AIYAA-1011/triple-J---UAV/飞控原理图&PCB.docx

## Part 1 简介

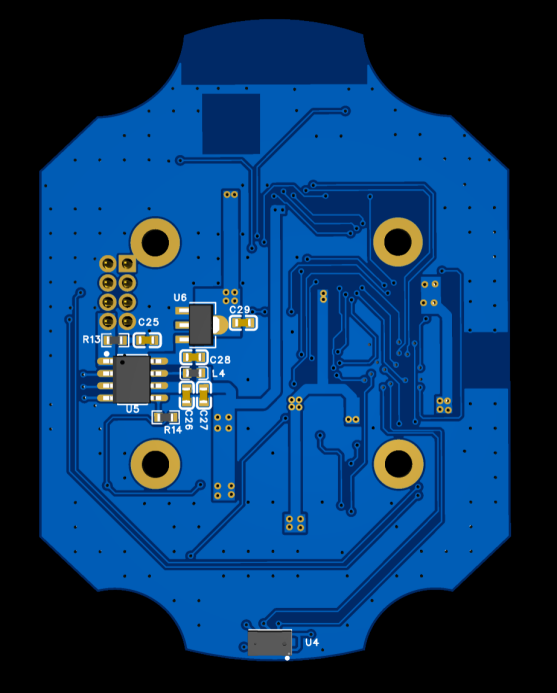
[picture p27: figure]
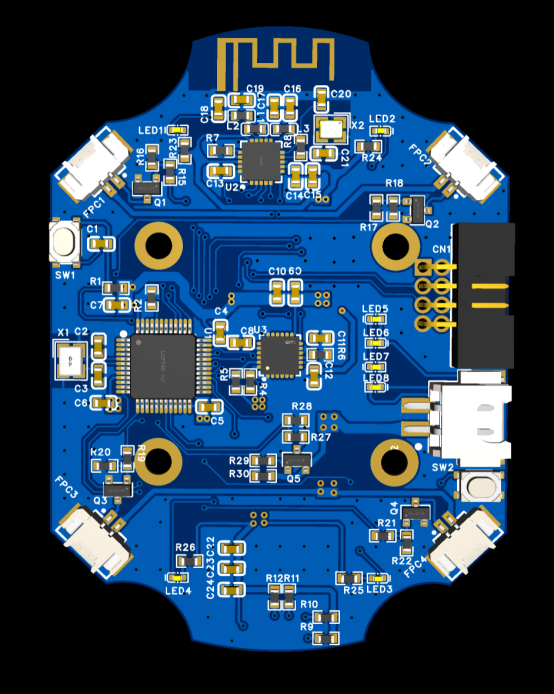
[picture p28: figure]

## Part 2 原理图具体细节

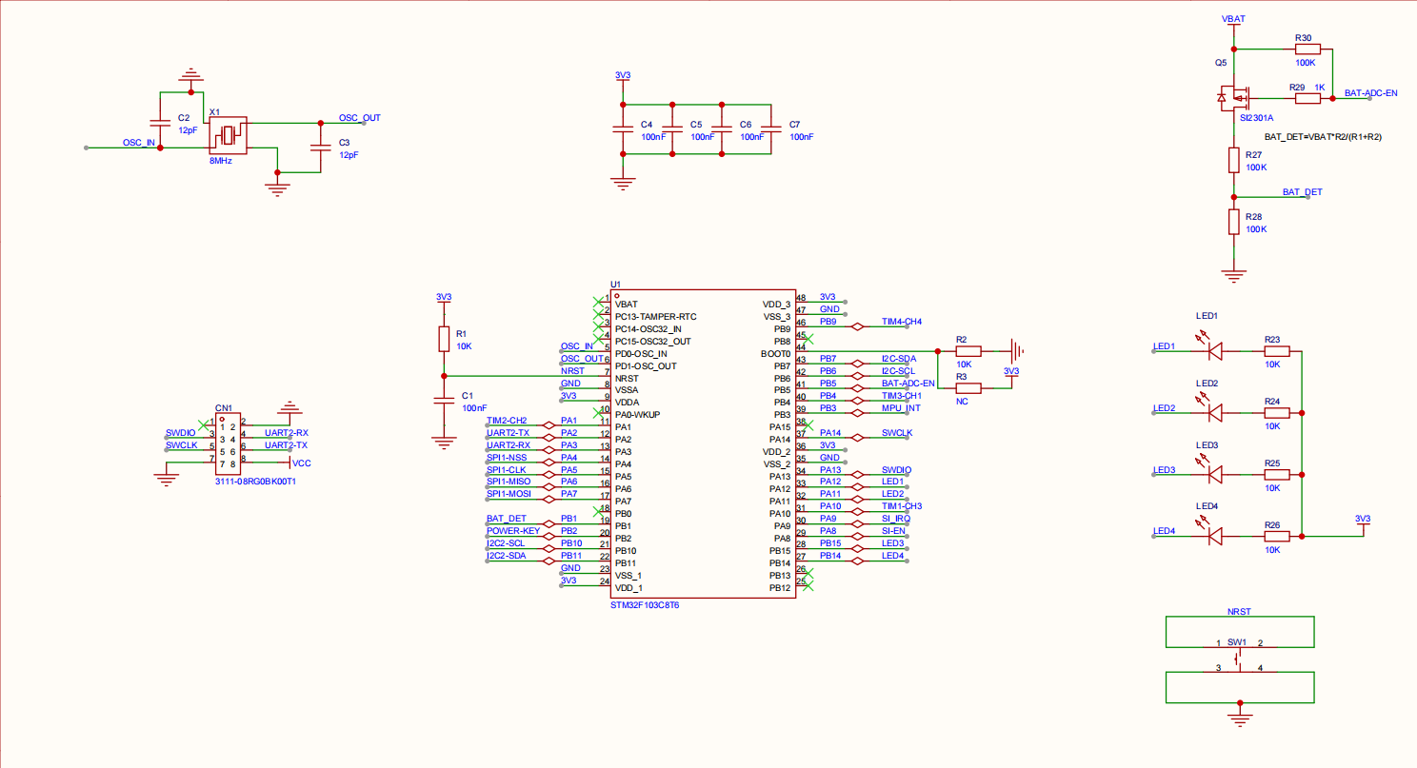
[picture p29: figure]
屏幕截图 2026-07-25 225838
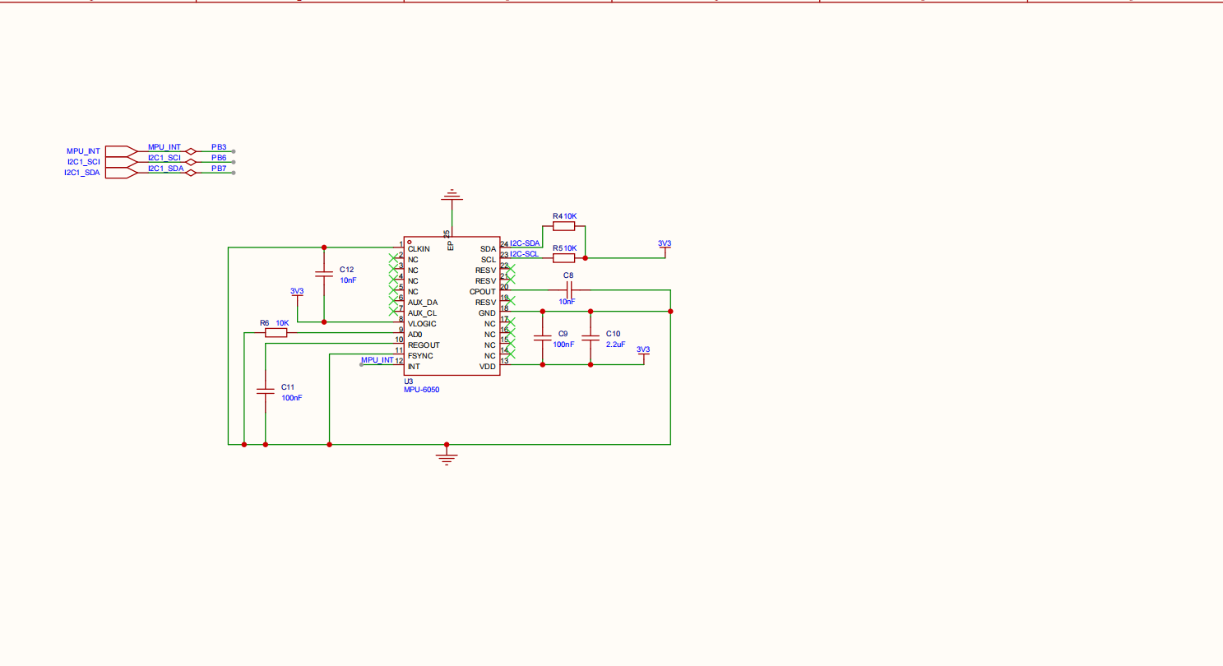
[picture p30: figure]
屏幕截图 2026-07-25 225851
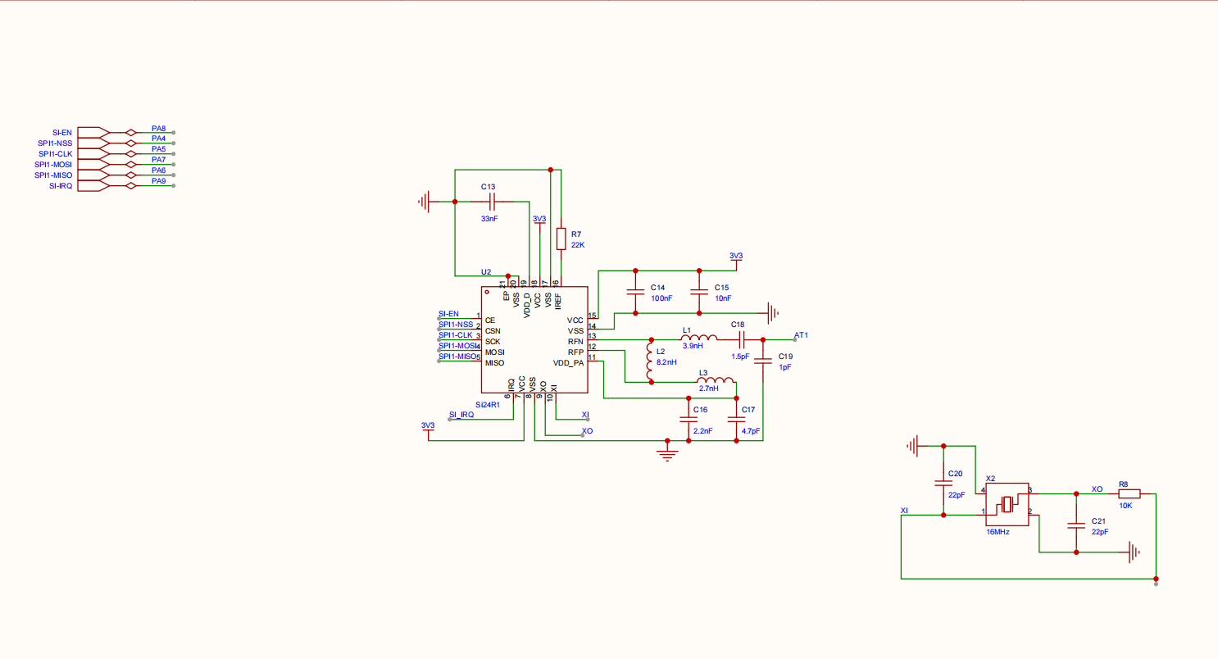
[picture p31: figure]
屏幕截图 2026-07-25 225900
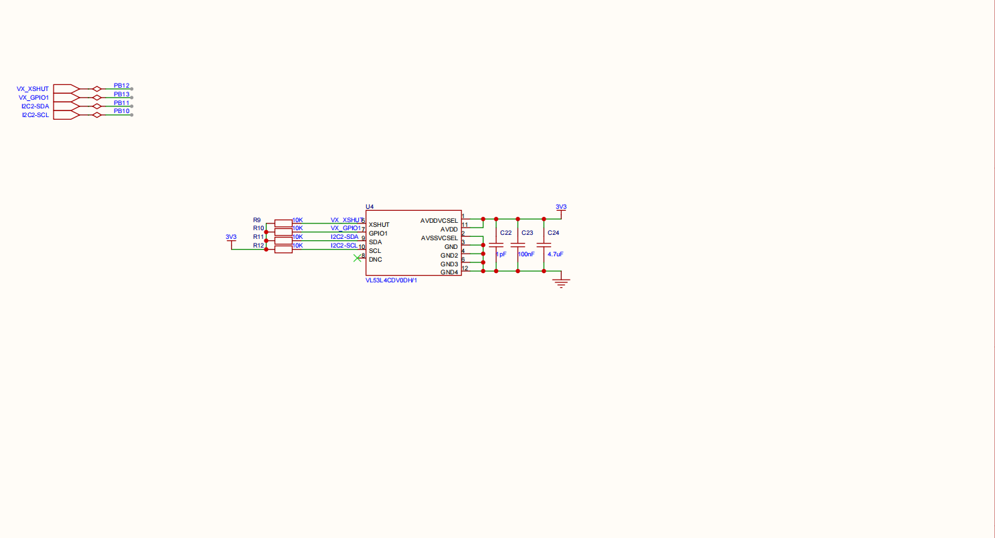
[picture p32: figure]
屏幕截图 2026-07-25 225908
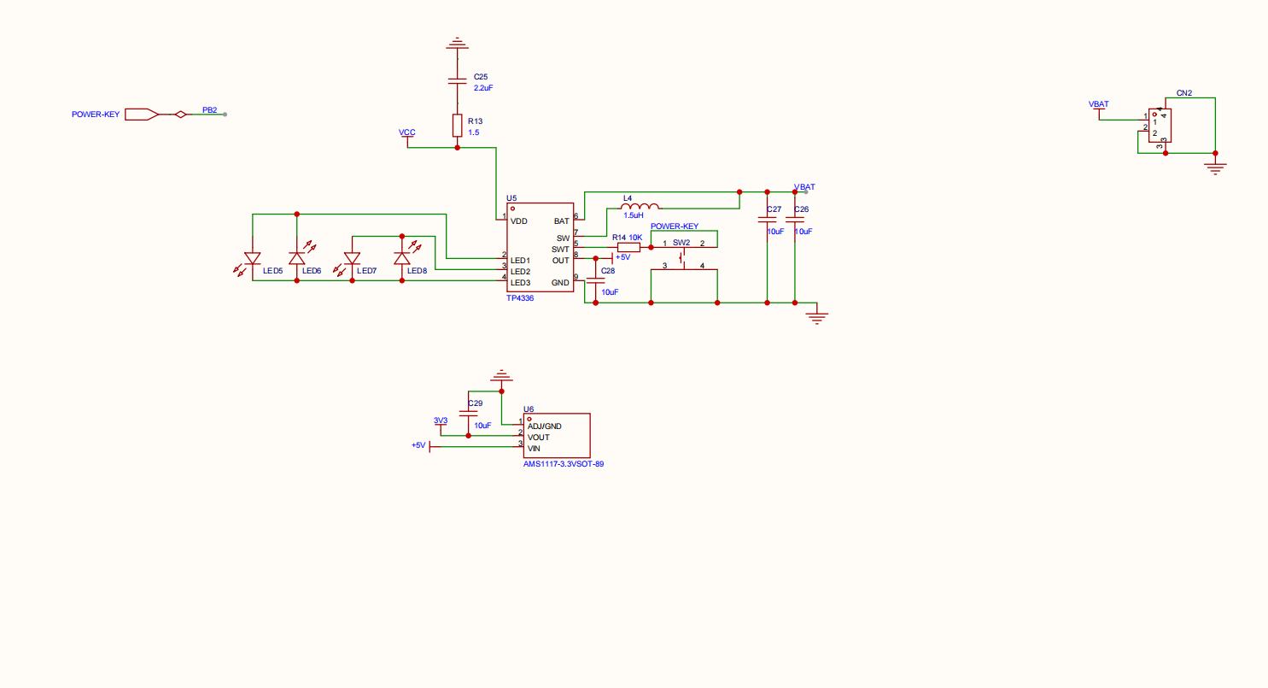
[picture p33: figure]
屏幕截图 2026-07-25 225916
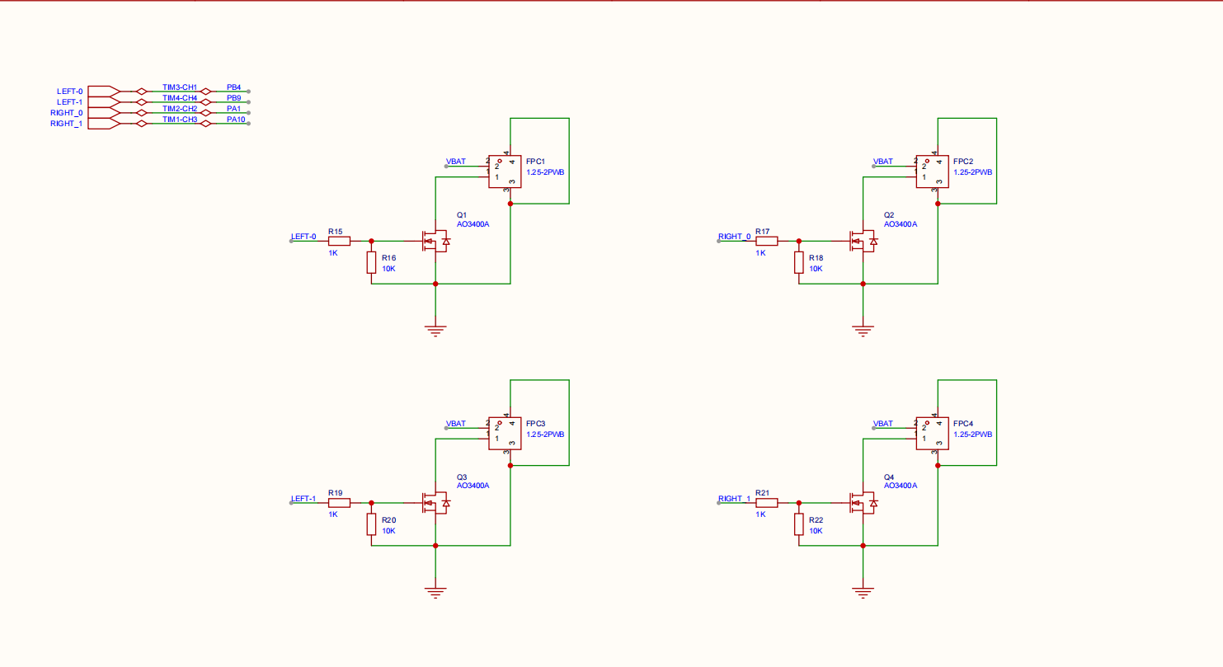
[picture p34: figure]
屏幕截图 2026-07-25 225924

## Part 3 PCB走线

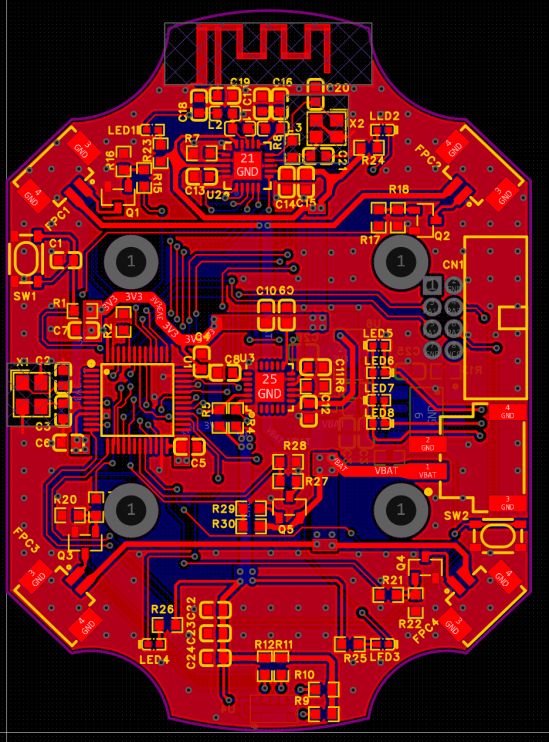
[picture p35: figure]
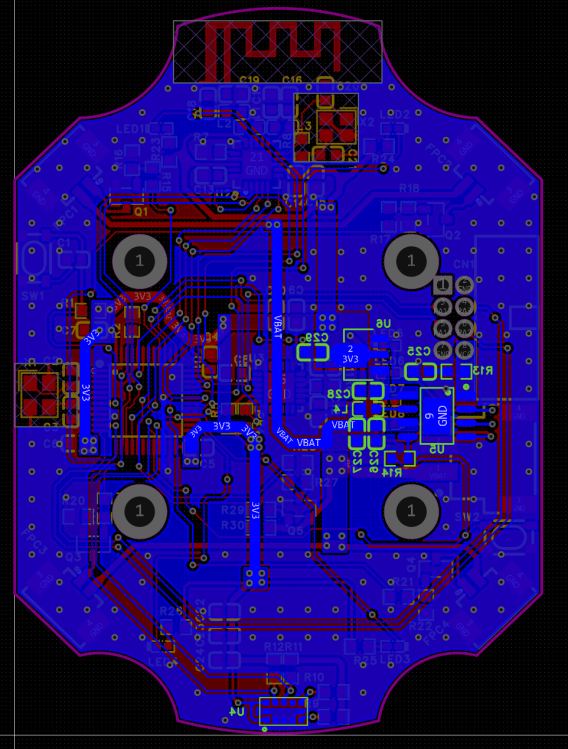
[picture p36: figure]

## Part 4 总结

1. PCB走线规划：网络布局，同一层的线路尽量保持同一走向，避免出现线路走不通或铺铜“孤岛”出现，尤其在元器件较多时，可以减少调整的时间。
2. 元器件布局：陀螺仪要放在机器的中心，确保读数准确；天线区域正反都不能铺铜，避免干扰；晶振尽量不要放在边缘，容易损坏。\

杨施杰

2026/8/28
