AIYAA-1011/triple-J---UAV/滤波和姿态解算.docx

滤波处理数据

问题：采集到的数据抖动（有毛刺）

对角速度进行低通滤波（对采集的数据时效性要求高、精度上较宽容，适合低通滤波）：

输出值=加权系数*上次输出值+（1-加权系数）*本次测量值

对加速度进行卡尔曼滤波（加速度抖动更剧烈，低通滤波不够用）：卡尔曼滤波主要是利用预测和测量之间的加权平均，结合系统的不确定性以及测量噪声来计算最优估计值。实现：

初始化：记录一组初始状态值->测量：获取当前加速度和方差/平均值->使用初始化的k值：得到当前输出值并记录结果方差->下次测量前：更新状态、重新计算k增益系数->重复测量。

姿态解算

通过加速度和角速度计算当前飞机的倾斜情况

互补解算：角速度解算长时间积分误差累计、加速度解算不能计算偏航角（Z），因此要二者结合。加速度解算X/Y轴、角速度解算Z轴

四元数姿态解算：优于互补解算，比较复杂，直接移植。

杨施杰

2026/8/28
