AIYAA-1011/triple-J---UAV/电机控制任务与点亮小灯.docx

电机控制任务与点亮小灯

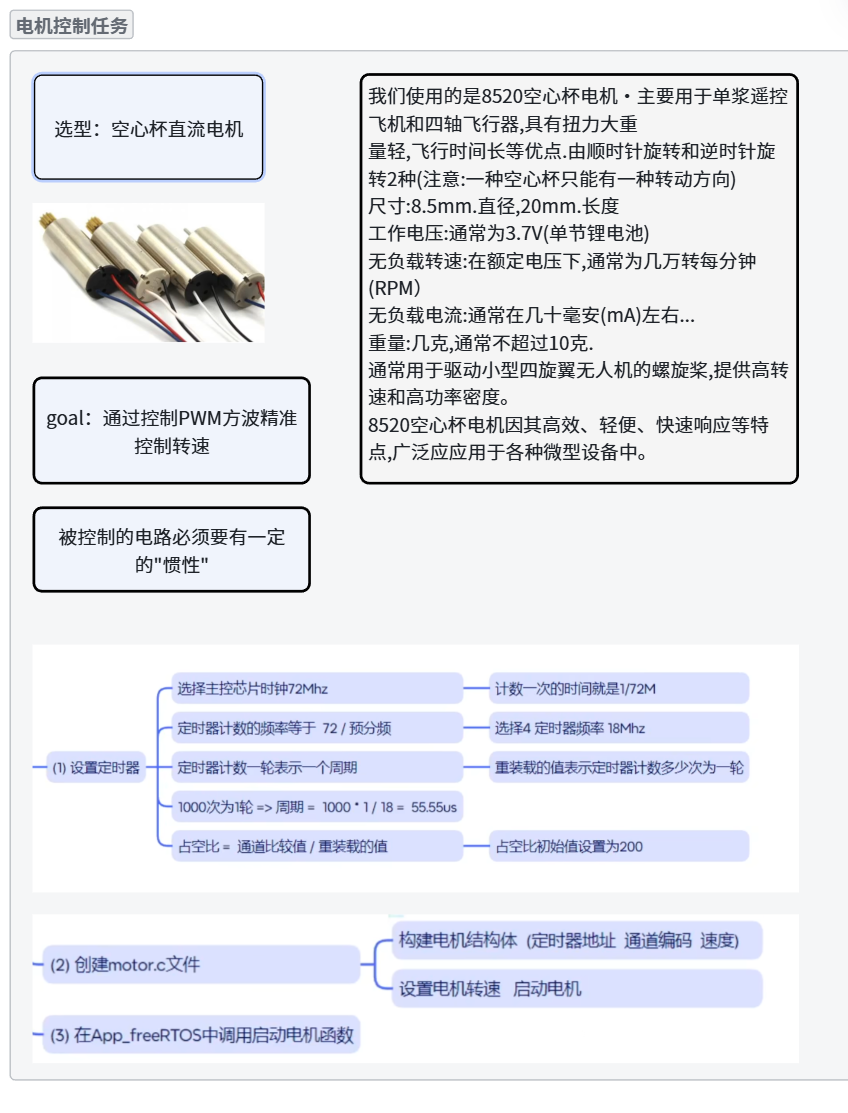
[picture p43: figure]
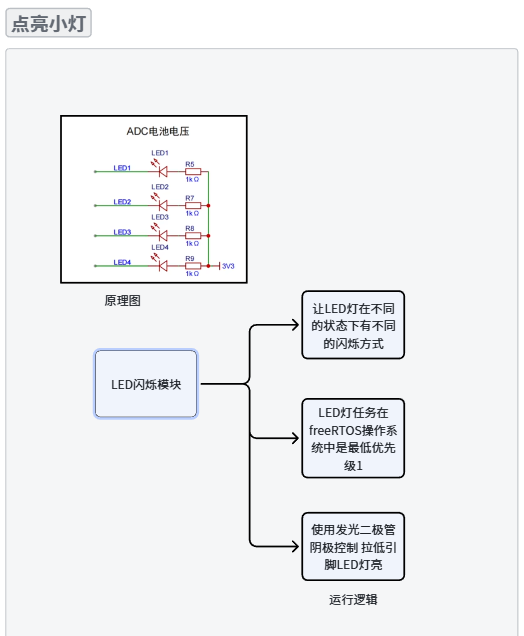
[picture p44: figure]

雷理杰

2026/8/28
