AIYAA-1011/triple-J---UAV/(list of files, drawings)

Other design files:
triple-J UAV 原理图+PCB.epro
