AIYAA-1011/triple-J---UAV/(commit log)

2026-07-29 首次提交：嘉立创 EDA 工程
    [triple-J UAV 原理图+PCB.epro]
2026-08-15 Create docs
    记录
2026-08-15 Create pcb.md
    放飞机主控芯片和遥控器原理图和pcb等硬件部分
2026-08-15 Add files via upload
    做到第125个
2026-08-28 Create 技术文档
2026-08-28 技术文档
